hyano/BlueSCSI-v2/hardware/MDR_50Pin/3dmodels/README.md

Referneces

* 10150-3000ve.stp
  https://www.3mcompany.jp/3M/ja_JP/p/dc/v100868325/
  (C) 3M 2025. All Rights Reserved.

* SC0915.STEP
  https://www.digikey.jp/ja/models/13624793
  Copyright (C) 1995-2025, DigiKey. All Rights Reserved.
