hyano/BlueSCSI-v2/hardware/MDR_50Pin/PrintedCase/MDR_50Pin.FCStd

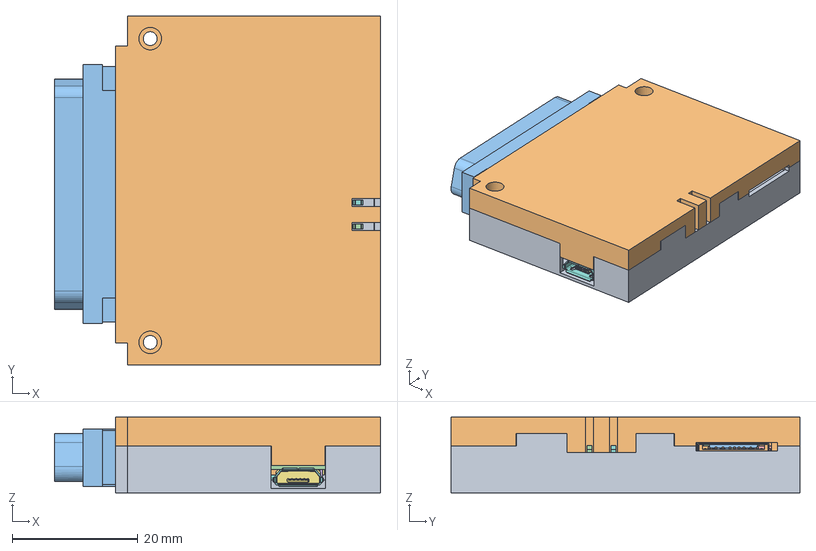
[picture p1: CAD file, 2025-10-05]
hardware/MDR_50Pin/PrintedCase/MDR_50Pin.FCStd
51.9 x 55.4 x 12.0 mm
Bottom
Top
C_1206_3216Metric
C_1206_3216Metric001
SOT-223
C_0603_1608Metric
C_0603_1608Metric001
C_0603_1608Metric002
C_0603_1608Metric003
D_SMA
R_0402_1005Metric
R_0402_1005Metric001
R_0402_1005Metric002
R_0402_1005Metric003
R_0402_1005Metric004
LED_0603_1608Metric
R_0402_1005Metric005
C_0805_2012Metric
R_0402_1005Metric006
R_0402_1005Metric007
R_0402_1005Metric008
R_0402_1005Metric009
C_0603_1608Metric004
R_0402_1005Metric010
R_0402_1005Metric011
R_0402_1005Metric012
R_0402_1005Metric013
LED_0603_1608Metric001
R_0402_1005Metric014
TSSOP-20_4.4x6.5mm_P0.65mm
R_0402_1005Metric015
C_0603_1608Metric005
C_0603_1608Metric006
SOIC-14_3.9x8.7mm_P1.27mm
R_0402_1005Metric016
R_0402_1005Metric017
C_0603_1608Metric007
R_0402_1005Metric018
R_0402_1005Metric019
R_0402_1005Metric020
R_0402_1005Metric021
TF-SMD_TF-06A
TF-SMD_TF-06A001
R_0402_1005Metric022
R_0402_1005Metric023
C_0603_1608Metric008
C_0603_1608Metric009
R_0402_1005Metric024
R_0402_1005Metric025
TSSOP-14_4.4x5mm_P0.65mm
R_0402_1005Metric026
Fuse_0805_2012Metric
R_0402_1005Metric027
R_0402_1005Metric028
R_0402_1005Metric029
TSSOP-14_4.4x5mm_P0.65mm001
R_0402_1005Metric030
TSSOP-20_4.4x6.5mm_P0.65mm001
10150-3000ve
PinHeader_1x13_P2.54mm_Horizontal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
