hyano/BlueSCSI-v2/hardware/MDR_50Pin/3dmodels/SC0915.STEP

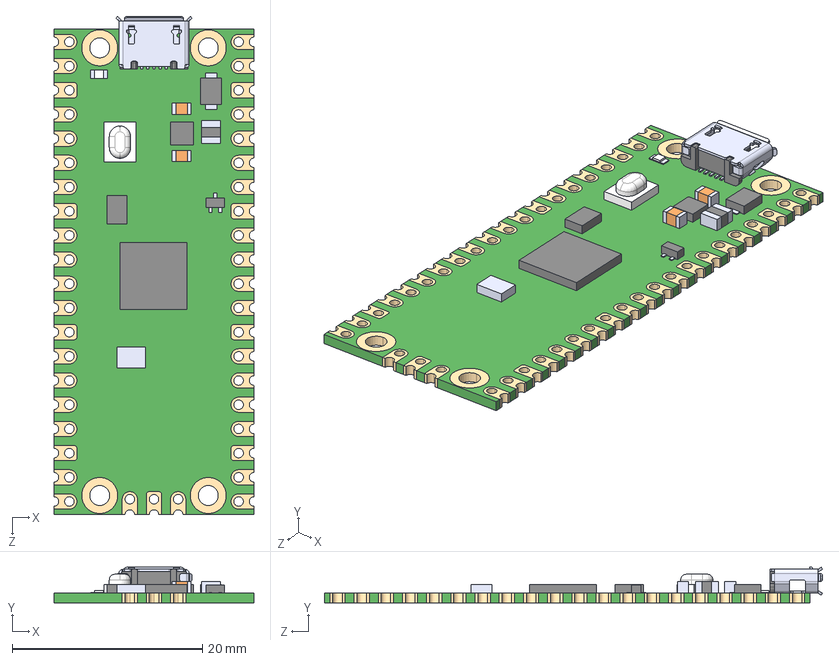
[picture p2: CAD file, 2025-09-15]
hardware/MDR_50Pin/3dmodels/SC0915.STEP
21.0 x 3.73 x 52.3 mm
