hyano/BlueSCSI-v2/hardware/MDR_50Pin/PrintedCase/MDR_50Pin-Bottom.stl

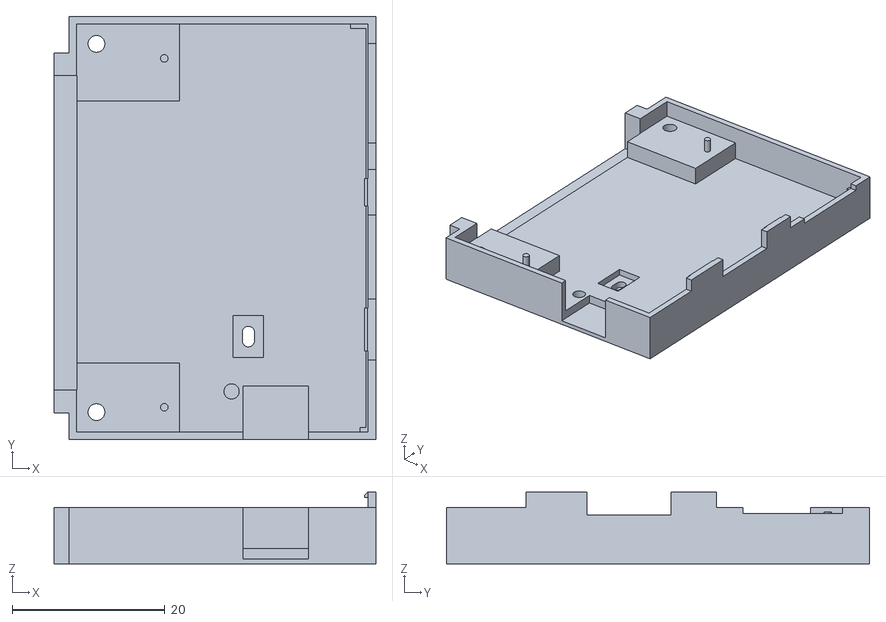
[picture p3: CAD file, 2025-10-05]
hardware/MDR_50Pin/PrintedCase/MDR_50Pin-Bottom.stl
42.2 x 55.4 x 9.40
