hyano/BlueSCSI-v2/hardware/MDR_50Pin/PrintedCase/MDR_50Pin-Top.stl

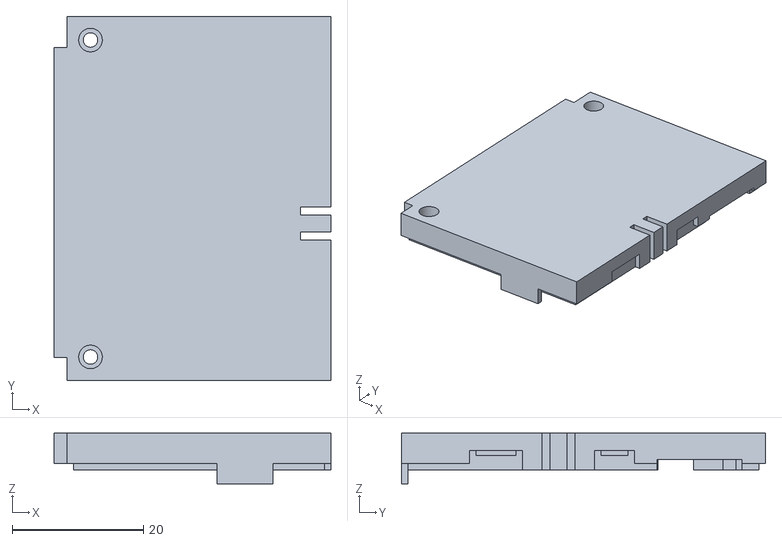
[picture p4: CAD file, 2025-09-30]
hardware/MDR_50Pin/PrintedCase/MDR_50Pin-Top.stl
42.2 x 55.4 x 7.70
