hyano/BlueSCSI-v2/hardware/MDR_50Pin/3dmodels/10150-3000ve.stp

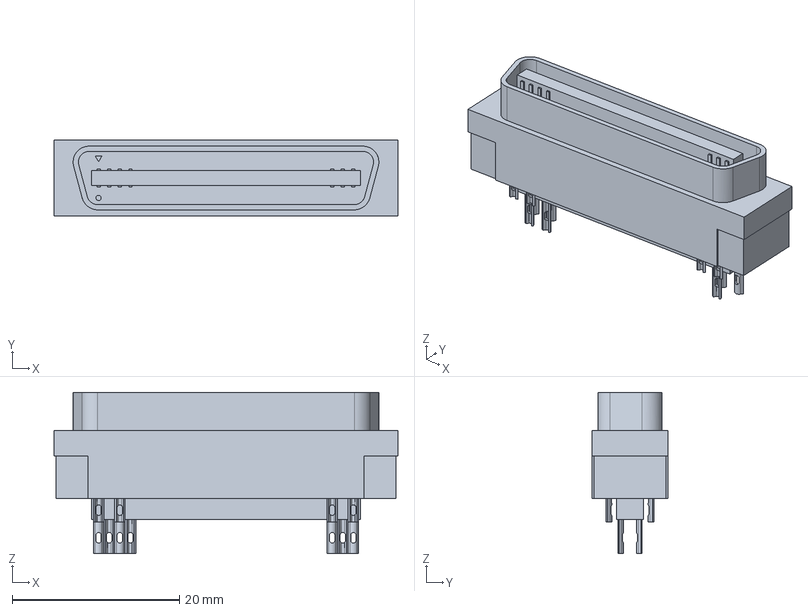
[picture p5: CAD file, 2025-09-15]
hardware/MDR_50Pin/3dmodels/10150-3000ve.stp
41.1 x 9.14 x 19.3 mm
