hyano/BlueSCSI-v2/hardware/MDR_50Pin/MDR_50Pin.kicad_pcb

## KiCad design hardware/MDR_50Pin/MDR_50Pin.kicad_pcb (2025-09-15)

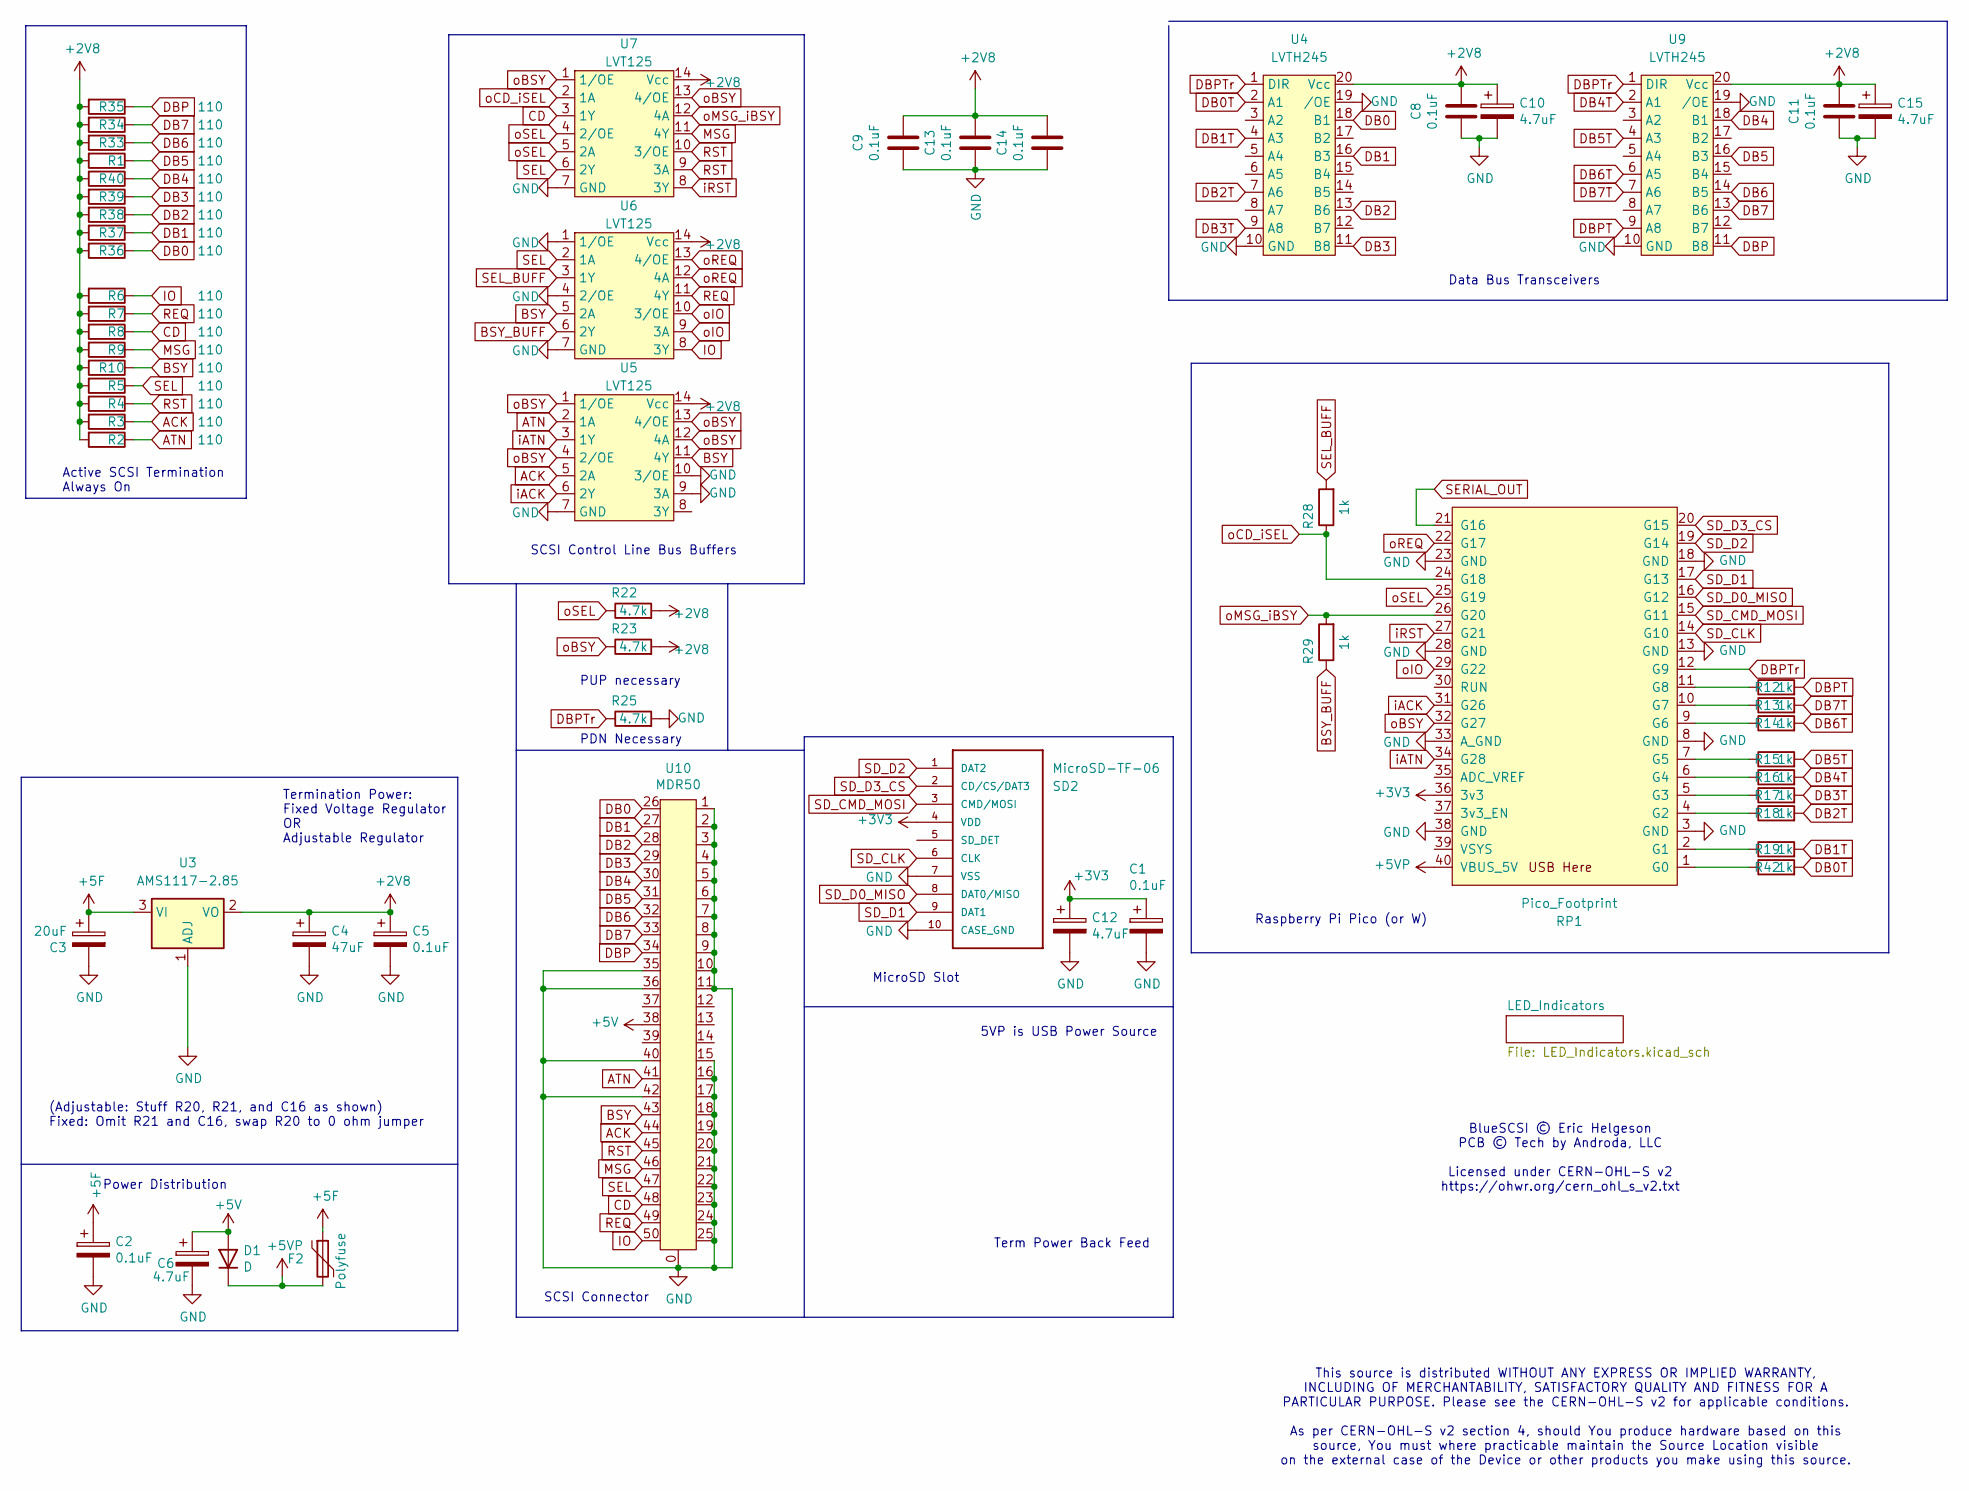
[picture p6: schematic MDR_50Pin.kicad_sch, BlueSCSI V2, Centronics 50 Pin, 2024.03a]

Parts:
C1, C2, C5, C8, C9, C11, C13, C14: 0.1uF; C_0603_1608Metric; LCSC Part # C14663
C3: 20uF; C_1206_3216Metric; LCSC Part # C5672
C4: 47uF; C_1206_3216Metric; LCSC Part # C96123
C6, C10, C12, C15: 4.7uF; C_0603_1608Metric; LCSC Part # C19666
D1: D; D_SMA; LCSC Part # C2480
F2: Polyfuse; Fuse_0805_2012Metric; LCSC Part # C883111
R1, R2, R3, R4, R5, R6, R7, R8, R9, R10, R33, R34, R35, R36, R37, R38, R39, R40: 110; R_0402_1005Metric; LCSC Part # C25078
R12, R13, R14, R15, R16, R17, R18, R19, R28, R29, R42: 1k; R_0402_1005Metric; LCSC Part # C11702
R22, R23, R25: 4.7k; R_0402_1005Metric; LCSC Part # C25900
RP1: Pico_Footprint; RPi_Pico_SMD
SD2: MicroSD-TF-06; TF-SMD_TF-06A; MANUFACTURER_PART_NUMBER C693844; LCSC Part # C693844
U3: AMS1117-2.85; SOT-223-3_TabPin2; LCSC Part # C14791
U4, U9: LVTH245; TSSOP-20_4.4x6.5mm_P0.65mm; LCSC Part # C2652121
U5, U6, U7: LVT125; TSSOP-14_4.4x5mm_P0.65mm; LCSC Part # C7042
U10: MDR50

Connections:
+2V8: C4.1, C5.1, C8.1, C9.2, C10.1, C11.1, C13.2, C14.2, C15.1, R1.2, R2.2, R3.2, R4.2, R5.2, R6.2, R7.2, R8.2, R9.2, R10.2, R22.2, R23.2, R33.2, R34.2, R35.2, R36.2, R37.2, R38.2, R39.2, R40.2, U3.2 (VO), U4.20 (Vcc), U5.14 (Vcc), U6.14 (Vcc), U7.14 (Vcc), U9.20 (Vcc)
+3V3: C1.1, C12.1, RP1.36 (3v3), SD2.4 (VDD); also elsewhere on the board
+5F: C2.1, C3.1, F2.1, U3.3 (VI); also elsewhere on the board
+5V: C6.1, D1.2 (A), U10.38
+5VP: D1.1 (K), F2.2, RP1.40 (VBUS_5V)
ACK: R3.1, U5.5 (2A), U10.44
ATN: R2.1, U5.2 (1A), U10.41
BSY: R10.1, U5.11 (4Y), U6.5 (2A), U10.43
BSY_BUFF: R29.1, U6.6 (2Y)
CD: R8.1, U7.3 (1Y), U10.48
DB0: R36.1, U4.18 (B1), U10.26
DB0T: R42.2, U4.2 (A1)
DB1: R37.1, U4.16 (B3), U10.27
DB1T: R19.2, U4.4 (A3)
DB2: R38.1, U4.13 (B6), U10.28
DB2T: R18.2, U4.7 (A6)
DB3: R39.1, U4.11 (B8), U10.29
DB3T: R17.2, U4.9 (A8)
DB4: R40.1, U9.18 (B1), U10.30
DB4T: R16.2, U9.2 (A1)
DB5: R1.1, U9.16 (B3), U10.31
DB5T: R15.2, U9.4 (A3)
DB6: R33.1, U9.14 (B5), U10.32
DB6T: R14.2, U9.6 (A5)
DB7: R34.1, U9.13 (B6), U10.33
DB7T: R13.2, U9.7 (A6)
DBP: R35.1, U9.11 (B8), U10.34
DBPT: R12.2, U9.9 (A8)
DBPTr: R25.1, RP1.12 (G9), U4.1 (DIR), U9.1 (DIR)
GND: C1.2, C2.2, C3.2, C4.2, C5.2, C6.2, C8.2, C9.1, C10.2, C11.2, C12.2, C13.1, C14.1, C15.2, R25.2, RP1.3 (GND), RP1.8 (GND), RP1.13 (GND), RP1.18 (GND), RP1.23 (GND), RP1.28 (GND), RP1.33 (A_GND), RP1.38 (GND), SD2.7 (VSS), SD2.10 (CASE_GND), U3.1 (ADJ), U4.10 (GND), U4.19 (/OE), U5.7 (GND), U5.9 (3A), U5.10 (3/OE), U6.1 (1/OE), U6.4 (2/OE), U6.7 (GND), U7.7 (GND), U9.10 (GND), U9.19 (/OE), U10.0, U10.1, U10.2, U10.3, U10.4, U10.5, U10.6, U10.7, U10.8, U10.9, U10.10, U10.11, U10.15, U10.16, U10.17, U10.18, U10.19, U10.20, U10.21, U10.22, U10.23, U10.24, U10.25, U10.35, U10.36, U10.40, U10.42; also elsewhere on the board
IO: R6.1, U6.8 (3Y), U10.50
MSG: R9.1, U7.11 (4Y), U10.46
unnamed: R42.1, RP1.1 (G0)
unnamed: R19.1, RP1.2 (G1)
unnamed: R18.1, RP1.4 (G2)
unnamed: R17.1, RP1.5 (G3)
unnamed: R16.1, RP1.6 (G4)
unnamed: R15.1, RP1.7 (G5)
unnamed: R14.1, RP1.9 (G6)
unnamed: R13.1, RP1.10 (G7)
unnamed: R12.1, RP1.11 (G8)
REQ: R7.1, U6.11 (4Y), U10.49
RST: R4.1, U7.9 (3A), U7.10 (3/OE), U10.45
SD_CLK: RP1.14 (G10), SD2.6 (CLK)
SD_CMD_MOSI: RP1.15 (G11), SD2.3 (CMD/MOSI)
SD_D0_MISO: RP1.16 (G12), SD2.8 (DAT0/MISO)
SD_D1: RP1.17 (G13), SD2.9 (DAT1)
SD_D2: RP1.19 (G14), SD2.1 (DAT2)
SD_D3_CS: RP1.20 (G15), SD2.2 (CD/CS/DAT3)
SEL: R5.1, U6.2 (1A), U7.6 (2Y), U10.47
SEL_BUFF: R28.2, U6.3 (1Y)
SERIAL_OUT: RP1.21 (G16)
iACK: RP1.31 (G26), U5.6 (2Y)
iATN: RP1.34 (G28), U5.3 (1Y)
iRST: RP1.27 (G21), U7.8 (3Y)
oBSY: R23.1, RP1.32 (G27), U5.1 (1/OE), U5.4 (2/OE), U5.12 (4A), U5.13 (4/OE), U7.1 (1/OE), U7.13 (4/OE); also elsewhere on the board
oCD_iSEL: R28.1, RP1.24 (G18), U7.2 (1A)
oIO: RP1.29 (G22), U6.9 (3A), U6.10 (3/OE)
oMSG_iBSY: R29.2, RP1.26 (G20), U7.12 (4A)
oREQ: RP1.22 (G17), U6.12 (4A), U6.13 (4/OE)
oSEL: R22.1, RP1.25 (G19), U7.4 (2/OE), U7.5 (2A)

Notes on the sheet:
Data Bus Transceivers
Termination Power: Fixed Voltage Regulator OR Adjustable Regulator
Active SCSI Termination Always On
Raspberry Pi Pico (or W)
Power Distribution
MicroSD Slot
SCSI Control Line Bus Buffers
SCSI Connector
5VP is USB Power Source
PDN Necessary
BlueSCSI © Eric Helgeson PCB © Tech by Androda, LLC Licensed under CERN-OHL-S v2 https://ohwr.org/cern_ohl_s_v2.txt
This source is distributed WITHOUT ANY EXPRESS OR IMPLIED WARRANTY, INCLUDING OF MERCHANTABILITY, SATISFACTORY QUALITY AND FITNESS FOR A PARTICULAR PURPOSE. Please see the CERN-OHL-S v2 for applicable conditions. As per CERN-OHL-S v2 section 4, should You produce hardware based on this source, You 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
Term Power Back Feed
(Adjustable: Stuff R20, R21, and C16 as shown) Fixed: Omit R21 and C16, swap R20 to 0 ohm jumper
PUP necessary

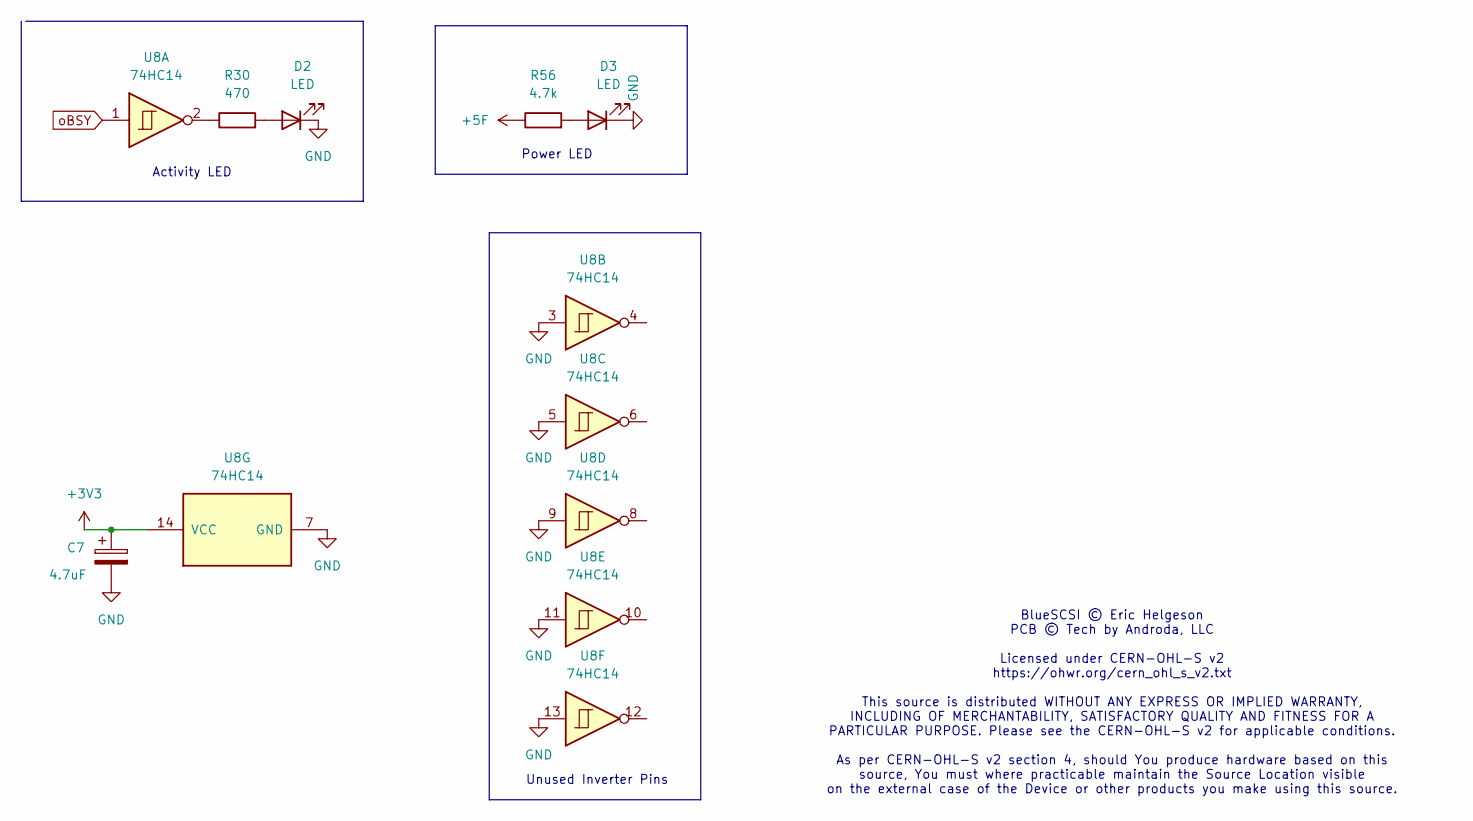
[picture p7: schematic LED_Indicators.kicad_sch, BlueSCSI V2, Centronics 50 Pin, 2024.03a]

Parts:
C7: 4.7uF; C_0805_2012Metric; LCSC Part # C1779
D2: LED; LED_0603_1608Metric; LCSC Part # C72041
D3: LED; LED_0603_1608Metric; LCSC Part # C2290
R30: 470; R_0402_1005Metric; LCSC Part # C25117
R56: 4.7k; R_0402_1005Metric; LCSC Part # C25900
U8: 74HC14; SOIC-14_3.9x8.7mm_P1.27mm; LCSC Part # C5605

Connections:
+3V3: C7.1, U8.14 (VCC); also elsewhere on the board
+5F: R56.1; also elsewhere on the board
GND: C7.2, D2.1 (K), D3.1 (K), U8.3, U8.5, U8.7 (GND), U8.9, U8.11, U8.13; also elsewhere on the board
unnamed: D2.2 (A), R30.2
unnamed: D3.2 (A), R56.2
unnamed: R30.1, U8.2
oBSY: U8.1; also elsewhere on the board

Notes on the sheet:
Power LED
Unused Inverter Pins
Activity LED
BlueSCSI © Eric Helgeson PCB © Tech by Androda, LLC Licensed under CERN-OHL-S v2 https://ohwr.org/cern_ohl_s_v2.txt This source is distributed WITHOUT ANY EXPRESS OR IMPLIED WARRANTY, INCLUDING OF MERCHANTABILITY, SATISFACTORY QUALITY AND FITNESS FOR A PARTICULAR PURPOSE. Please see the CERN-OHL-S 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

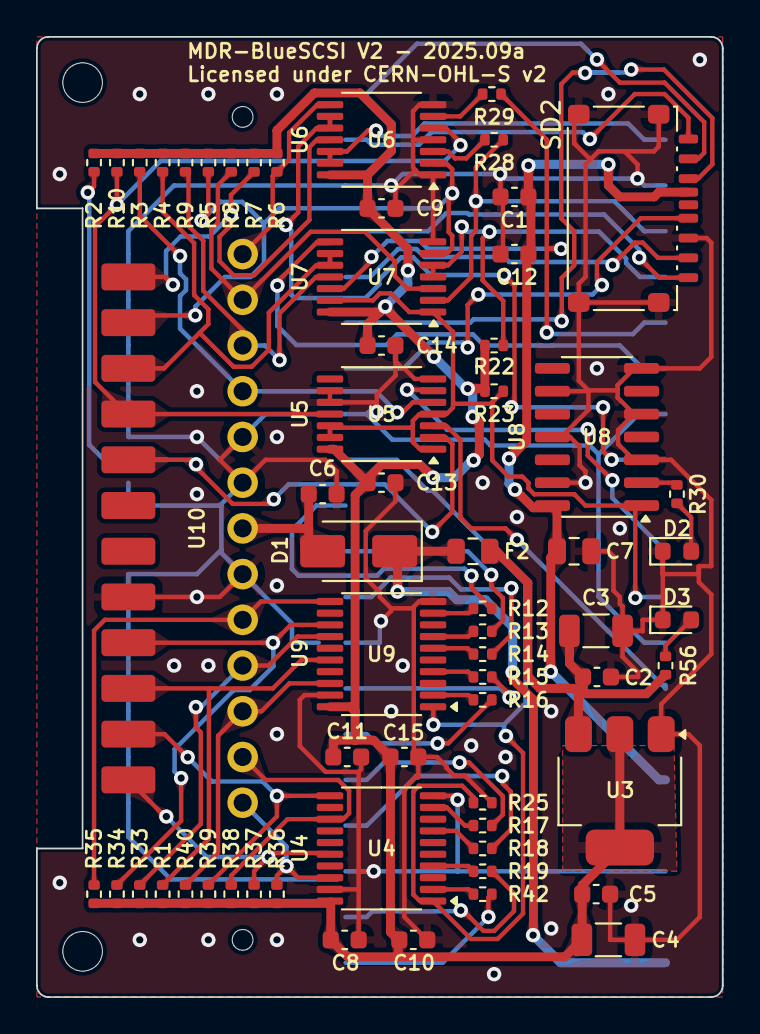
[picture p8: board MDR_50Pin.kicad_pcb from above]

Board: 2 copper layers, 38.1 x 53.3 mm, 63 parts (1 on the bottom side), 63 nets.
