hyano/BlueSCSI-v2/(commit log)

2025-09-07 copy from Centronics_50Pin
    [CaseBottom.stl, CaseTop.stl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]
2025-09-07 rename from Centronics_50Pin
    [MDR_50Pin.kicad_pcb, MDR_50Pin.kicad_sch]
2025-09-15 latest design
    [10150-3000ve.stp, CaseBottom.stl, CaseTop.stl, LED_Indicators.kicad_sch, MDR_50Pin-Bottom.stl, MDR_50Pin-Top.stl, MDR_50Pin.FCStd, MDR_50Pin.kicad_pcb]
2025-09-15 use tooling hole
    [MDR_50Pin.kicad_pcb]
2025-09-15 increase screw hole depth
    [MDR_50Pin-Bottom.stl, MDR_50Pin-Top.stl, MDR_50Pin.FCStd]
2025-09-20 widen LED window
    [MDR_50Pin.FCStd]
2025-09-20 fixed unattached sketch
    [MDR_50Pin.FCStd]
2025-09-23 minor modification
    [MDR_50Pin-Bottom.stl, MDR_50Pin-Top.stl, MDR_50Pin.FCStd]
2025-10-05 reduce the size of nut hole
    [MDR_50Pin-Bottom.stl, MDR_50Pin.FCStd]
2025-10-05 Fixed circular dependencies
    [MDR_50Pin-Bottom.stl, MDR_50Pin.FCStd]
2025-10-05 update production data
    [designators.csv]
